SonOfPear93/gaggimate/hardware/knob/pcb/knob-main/fab/drc-report.txt

** Drc report for knob-main.kicad_pcb **
** Created on 2026-11-07T16:05:16 **
** Report includes: Errors, Warnings, Exclusions **

** Found 2 DRC violations **
[silk_edge_clearance]: Silkscreen clipped by board edge
    Rule: board setup constraints silk; warning
    @(100.0000 mm, 100.0000 mm): Circle on Edge.Cuts
    @(64.8000 mm, 95.3000 mm): Segment of J1 on F.Silkscreen
[silk_edge_clearance]: Silkscreen clipped by board edge
    Rule: board setup constraints silk; warning
    @(100.0000 mm, 100.0000 mm): Circle on Edge.Cuts
    @(64.8000 mm, 104.7000 mm): Segment of J1 on F.Silkscreen

** Found 0 unconnected pads **

** Found 0 Footprint errors **

** Ignored checks **
    - Footprint has no courtyard defined
    - Track endpoint not centered on via
    - Tuning profile track geometries
    - Footprint doesn't match symbol's footprint filters
    - Footprint component type doesn't match footprint pads

** End of Report **
