SonOfPear93/gaggimate/hardware/knob/pcb/knob-main/fab/erc-report.txt

ERC report (2026-11-07T16:05:14, Encoding UTF8)
Report includes: Errors, Warnings, Exclusions

***** Sheet /

 ** ERC messages: 0  Errors 0  Warnings 0

 ** Ignored checks:
    - Global label only appears once in the schematic
    - Four connection points are joined together
    - SPICE model issue
    - Assigned footprint doesn't match footprint filters
