SonOfPear93/gaggimate/hardware/knob/pcb/knob-screen/fab/drc-report.txt

** Drc report for knob-screen.kicad_pcb **
** Created on 2026-11-07T15:58:11 **
** Report includes: Errors, Warnings, Exclusions **

** Found 0 DRC violations **

** Found 0 unconnected pads **

** Found 0 Footprint errors **

** Ignored checks **
    - Footprint has no courtyard defined
    - Track endpoint not centered on via
    - Tuning profile track geometries
    - Footprint doesn't match symbol's footprint filters
    - Footprint component type doesn't match footprint pads

** End of Report **
