SonOfPear93/gaggimate/hardware/knob/pcb/knob-screen/fab/knob-screen-schematic.pdf

1 | 2 | 3 | 4 | 5 | 6 | 7 | 8
1 | 2 | 3 | 4 | 5 | 6 | 7 | 8

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
Size: A3 | Rev: 1 | F Date: 2026-11-07
KiCad E.D.A. 10.0.6 | Id: 1/1

### Title: GaggiMate Knob - board C (screen adapter)

File: knob-screen.kicad_sch

Sheet: /

GaggiMate Knob

Adapter between the 1.75in CO5300/CST9217 AMOLED (31-pin 0.3 mm FPC) and the 13-wire bundle to board B

FPC pinout copied from Waveshare ESP32-S3-Touch-AMOLED-1.75 schematic (J3). Panel makes its own AMOLED rails from 3V3.

I2C pull-ups for touch live on board B (to 3V3_LCD). No active parts on this board.

C1

10uF

TP1

LCD_TE

# Mounting 1

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
31 MP

J1

FH26W-31S-0.3SHW(60)

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
J2 WirePads13 H1M2 | H3M2 H2M2 | C4

100nF C3

100nF C2

1uF

GND

TP_SCL 3V3_LCD

3V3_LCD

3V3_LCD

GND

3V3_LCD
GND | 3V3_LCD GND 3V3_LCD
3V3_LCD | GND | 3V3_LCD | 3V3_LCD

TP_RST

TP_SCL

TP_INT | GND

LCD_D1

LCD_D0

# LCD_D3 GND

GND

# GND GND GND

LCD_D3 GND
LCD_TE
LCD_D2 | LCD_TE 3V3_LCD

LCD_CS
LCD_CLK

LCD_D2

LCD_CS GND

LCD_CLK

LCD_RST LCD_D0

LCD_D1

TP_SDA

TP_RST

TP_INT LCD_RST

TP_SDA Notes: - J1 sits on the panel-facing (top) side, positioned like Waveshare's J3 so the panel FPC tail folds behind

the glass and reaches it. FPC enters from -X (board left). Max part height on top: 1.0 mm (FPC fold gap ~2.3 mm). - J2 is 13 bare SMD pads on the bottom side in a ring r=5.5 mm around the board centre (motor hollow shaft). - Panel 3V3 (3V3_LCD) is switched on board B (LCD_EN). Bulk/HF decoupling here, close to the FPC 3V3 pins. - LCD_TE is brought to a test pad only.
