SonOfPear93/gaggimate/hardware/knob/pcb/knob-base/fab/knob-base-bottom.png

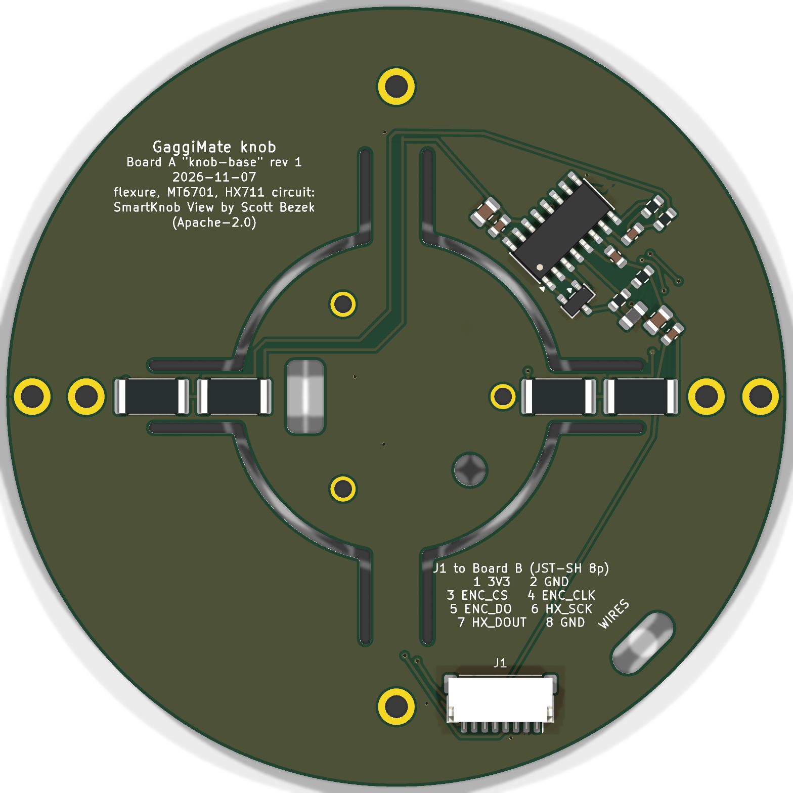
hardware/knob/pcb/knob-base/fab/knob-base-bottom.png
