SonOfPear93/gaggimate/hardware/knob/pcb/knob-main/fab/knob-main-render-bottom.png

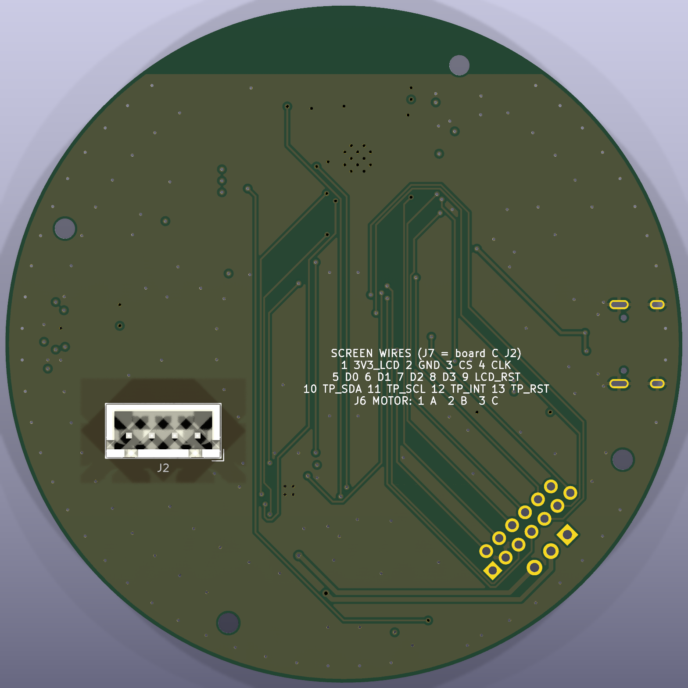
hardware/knob/pcb/knob-main/fab/knob-main-render-bottom.png
