SonOfPear93/gaggimate/hardware/knob/pcb/knob-main/fab/knob-main-render-top.png

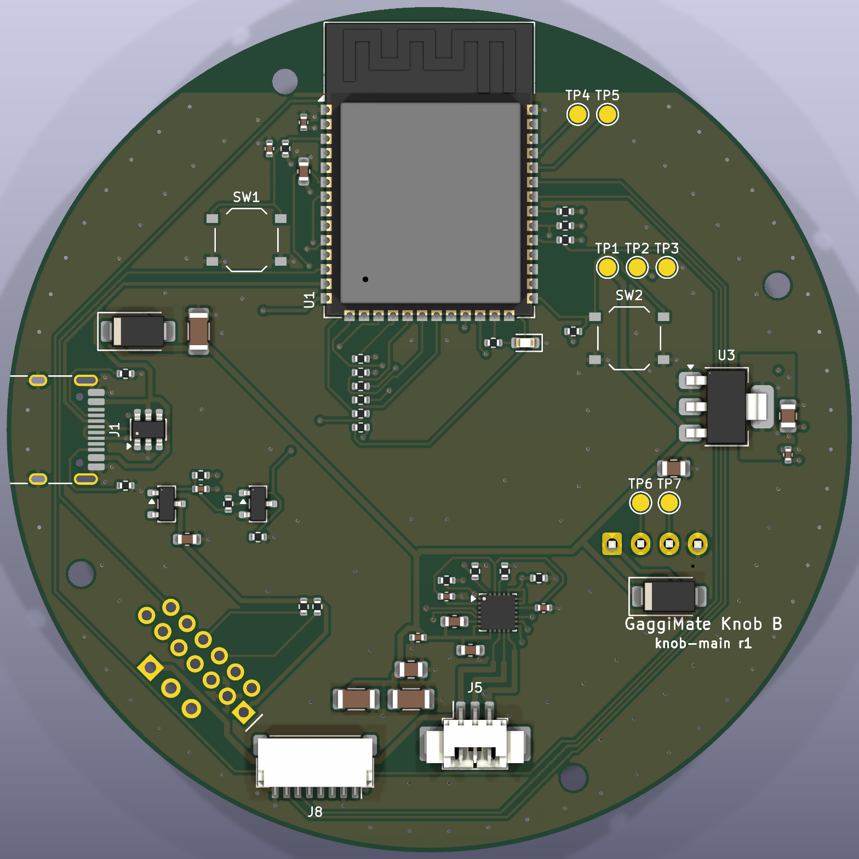
hardware/knob/pcb/knob-main/fab/knob-main-render-top.png
