SonOfPear93/gaggimate/hardware/knob/pcb/knob-screen/fab/knob-screen-render-bottom.png

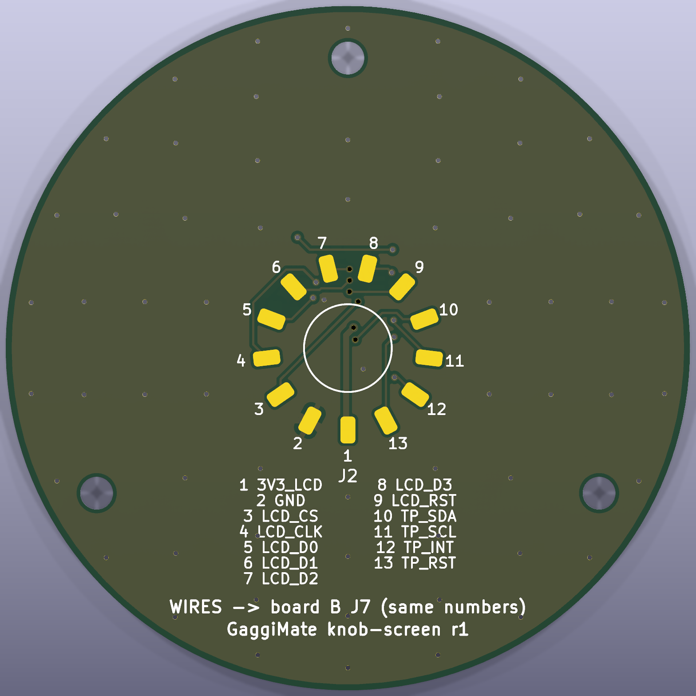
hardware/knob/pcb/knob-screen/fab/knob-screen-render-bottom.png
