SonOfPear93/gaggimate/hardware/knob/pcb/knob-screen/fab/knob-screen-render-top.png

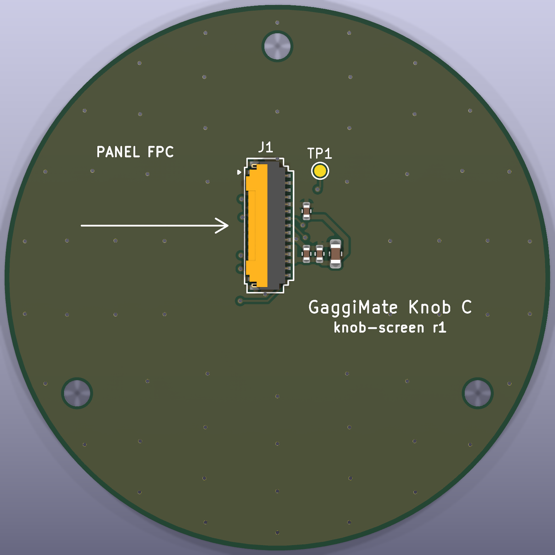
hardware/knob/pcb/knob-screen/fab/knob-screen-render-top.png
