SonOfPear93/gaggimate/hardware/knob/pcb/knob-main/fab/knob-main-BOM.csv

Comment | Designator | Footprint | LCSC
22uF/25V | C1,C14,C15 | C_1206_3216Metric | C12891
100nF/50V | C12,C13 | C_0603_1608Metric | C14663
10uF/25V | C2,C17 | C_0805_2012Metric | C15850
22uF | C3 | C_0805_2012Metric | C45783
100nF | C4,C6,C8,C10,C16 | C_0402_1005Metric | C1525
10uF | C5,C9 | C_0603_1608Metric | C19702
1uF | C7,C11 | C_0402_1005Metric | C52923
SS34 | D1,D2 | D_SMA | C8678
RED | D3 | LED_0603_1608Metric | C2286
USB-C | J1 | USB_C_Receptacle_HRO_TYPE-C-31-M-12 | C165948
B4B-XH-A | J2 | JST_XH_B4B-XH-A_1x04_P2.50mm_Vertical | C144395
53261-0371 | J5 | Molex_PicoBlade_53261-0371_1x03-1MP_P1.25mm_Horizontal | C293630
SM08B-SRSS-TB | J8 | JST_SH_SM08B-SRSS-TB_1x08-1MP_P1.00mm_Horizontal | C160407
AO3401A | Q1 | SOT-23 | C15127
2N7002 | Q2 | SOT-23 | C8545
5.1k | R1,R2 | R_0402_1005Metric | C25905
4.7k | R12,R13 | R_0402_1005Metric | C25900
100k | R14,R16,R18,R19 | R_0402_1005Metric | C25741
47k | R20 | R_0402_1005Metric | C25792
2.2k | R21,R22,R23 | R_0402_1005Metric | C25879
10k | R3,R4,R15,R17 | R_0402_1005Metric | C25744
1k | R5 | R_0402_1005Metric | C11702
33R | R6,R7,R8,R9,R10,R11 | R_0402_1005Metric | C25105
RESET | SW1 | SW_Push_1P1T_XKB_TS-1187A | C318884
BOOT | SW2 | SW_Push_1P1T_XKB_TS-1187A | C318884
ESP32-S3-WROOM-1-N16R8 | U1 | ESP32-S3-WROOM-1_EPvia0.3 | C2913202
USBLC6-2SC6 | U2 | SOT-23-6 | C2687116
AP7361C-33ER-13 | U3 | SOT-223-3_TabPin2 | C3743528
DRV8311HRRWR | U4 | Texas_RRW0024A_WQFN-24-1EP_3x3mm_P0.4mm_EP1.9x1.9mm | C5218862
