SonOfPear93/gaggimate/hardware/knob/pcb/knob-screen/fab/knob-screen-BOM.csv

Comment | Designator | Footprint | LCSC
10uF | C1 | C_0603_1608Metric | C19702
1uF | C2 | C_0402_1005Metric | C52923
100nF | C3,C4 | C_0402_1005Metric | C1525
FH26W-31S-0.3SHW(60) | J1 | Hirose_FH26-31S-0.3SHW_2Rows-31Pins-1MP_P0.60mm_Horizontal | C2973806
