SonOfPear93/gaggimate/hardware/knob/pcb/knob-base/fab/knob-base-BOM-JLC.csv

Comment | Designator | Footprint | LCSC Part #
100n | C12,C19,C20,C22,C23 | C_0603_1608Metric | C14663
10u | C16,C18 | C_0805_2012Metric | C15850
100R@100MHz | FB1 | L_0805_2012Metric | C1015
JST-SH 8p to Board B | J1 | JST_SH_SM08B-SRSS-TB_1x08-1MP_P1.00mm_Horizontal | C160407
SS8550 | Q1 | SOT-23 | C8542
10k | R3 | R_0603_1608Metric | C25804
8.2k | R4 | R_0603_1608Metric | C25981
100 | R5,R6 | R_0603_1608Metric | C22775
330 (strain) | R18,R19,R20,R21 | R_2512_6332Metric | C19866
MT6701CT-STD-R | U1 | SOIC-8_3.9x4.9mm_P1.27mm | C3003196
HX711 | U4 | SOIC-16_3.9x9.9mm_P1.27mm | C6705483
