SonOfPear93/gaggimate/hardware/knob/mechanical/reused/RotorSpacer.stl

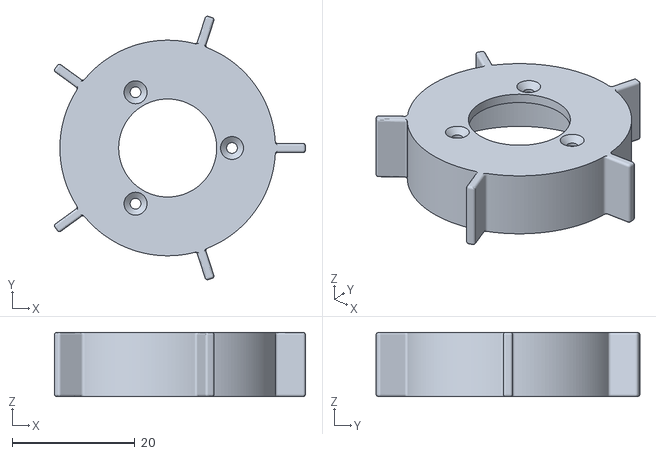
[picture p6: CAD file, 2026-11-07]
hardware/knob/mechanical/reused/RotorSpacer.stl
41.0 x 43.0 x 10.5
