SonOfPear93/gaggimate/hardware/knob/pcb/knob-main/knob-main.kicad_pcb

## KiCad design hardware/knob/pcb/knob-main/knob-main.kicad_pcb (2026-11-07)

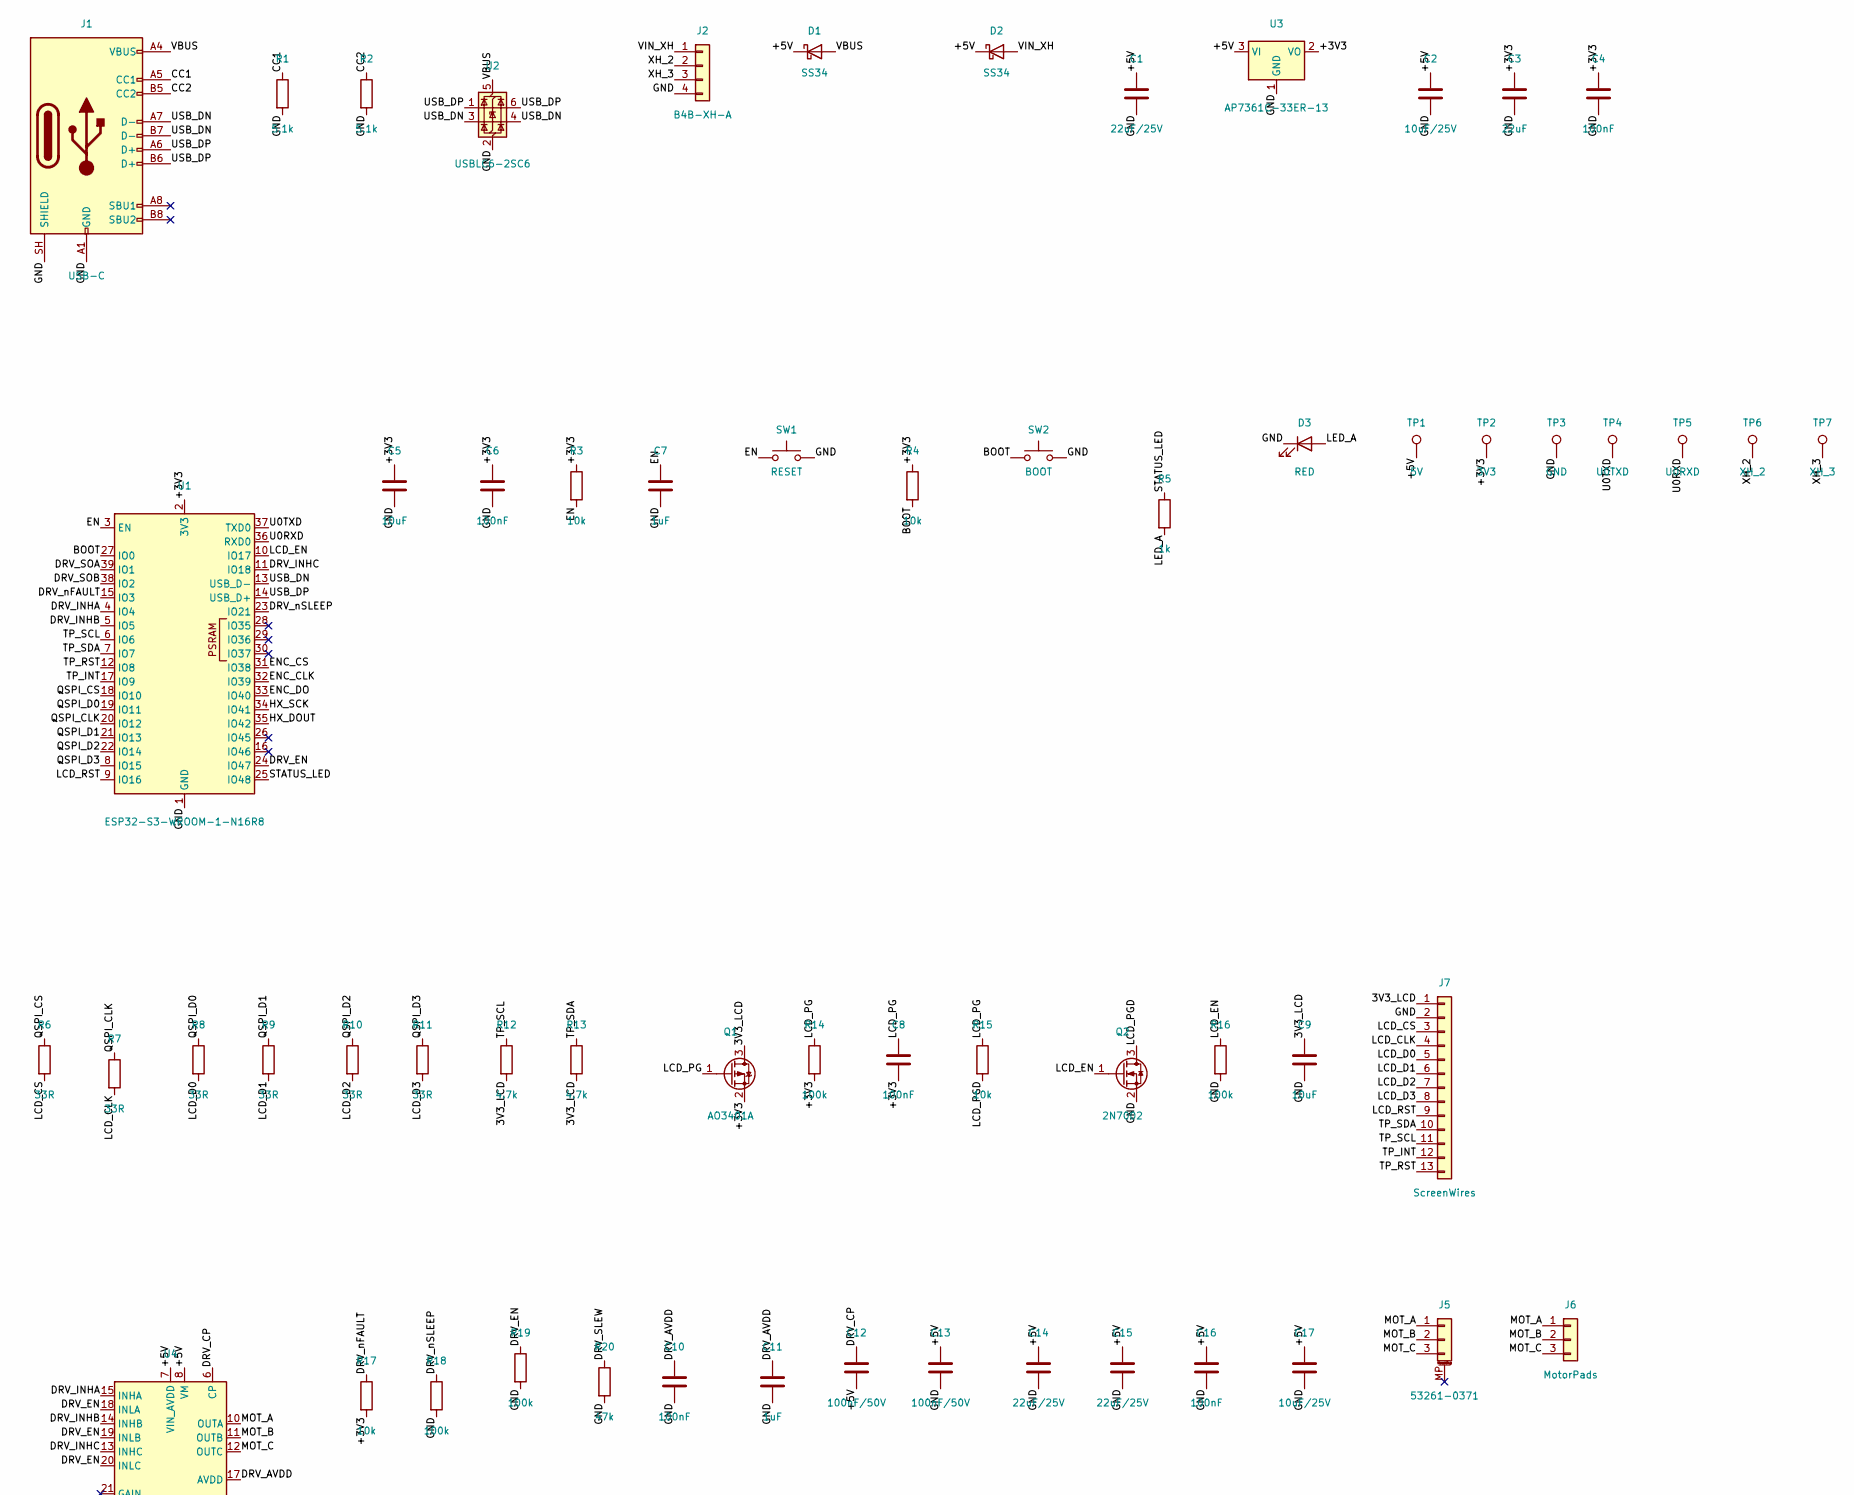
[picture p9: schematic knob-main.kicad_sch, GaggiMate Knob - board B (main: ESP32-S3, DRV8311H, power), part in row 1, column 1]

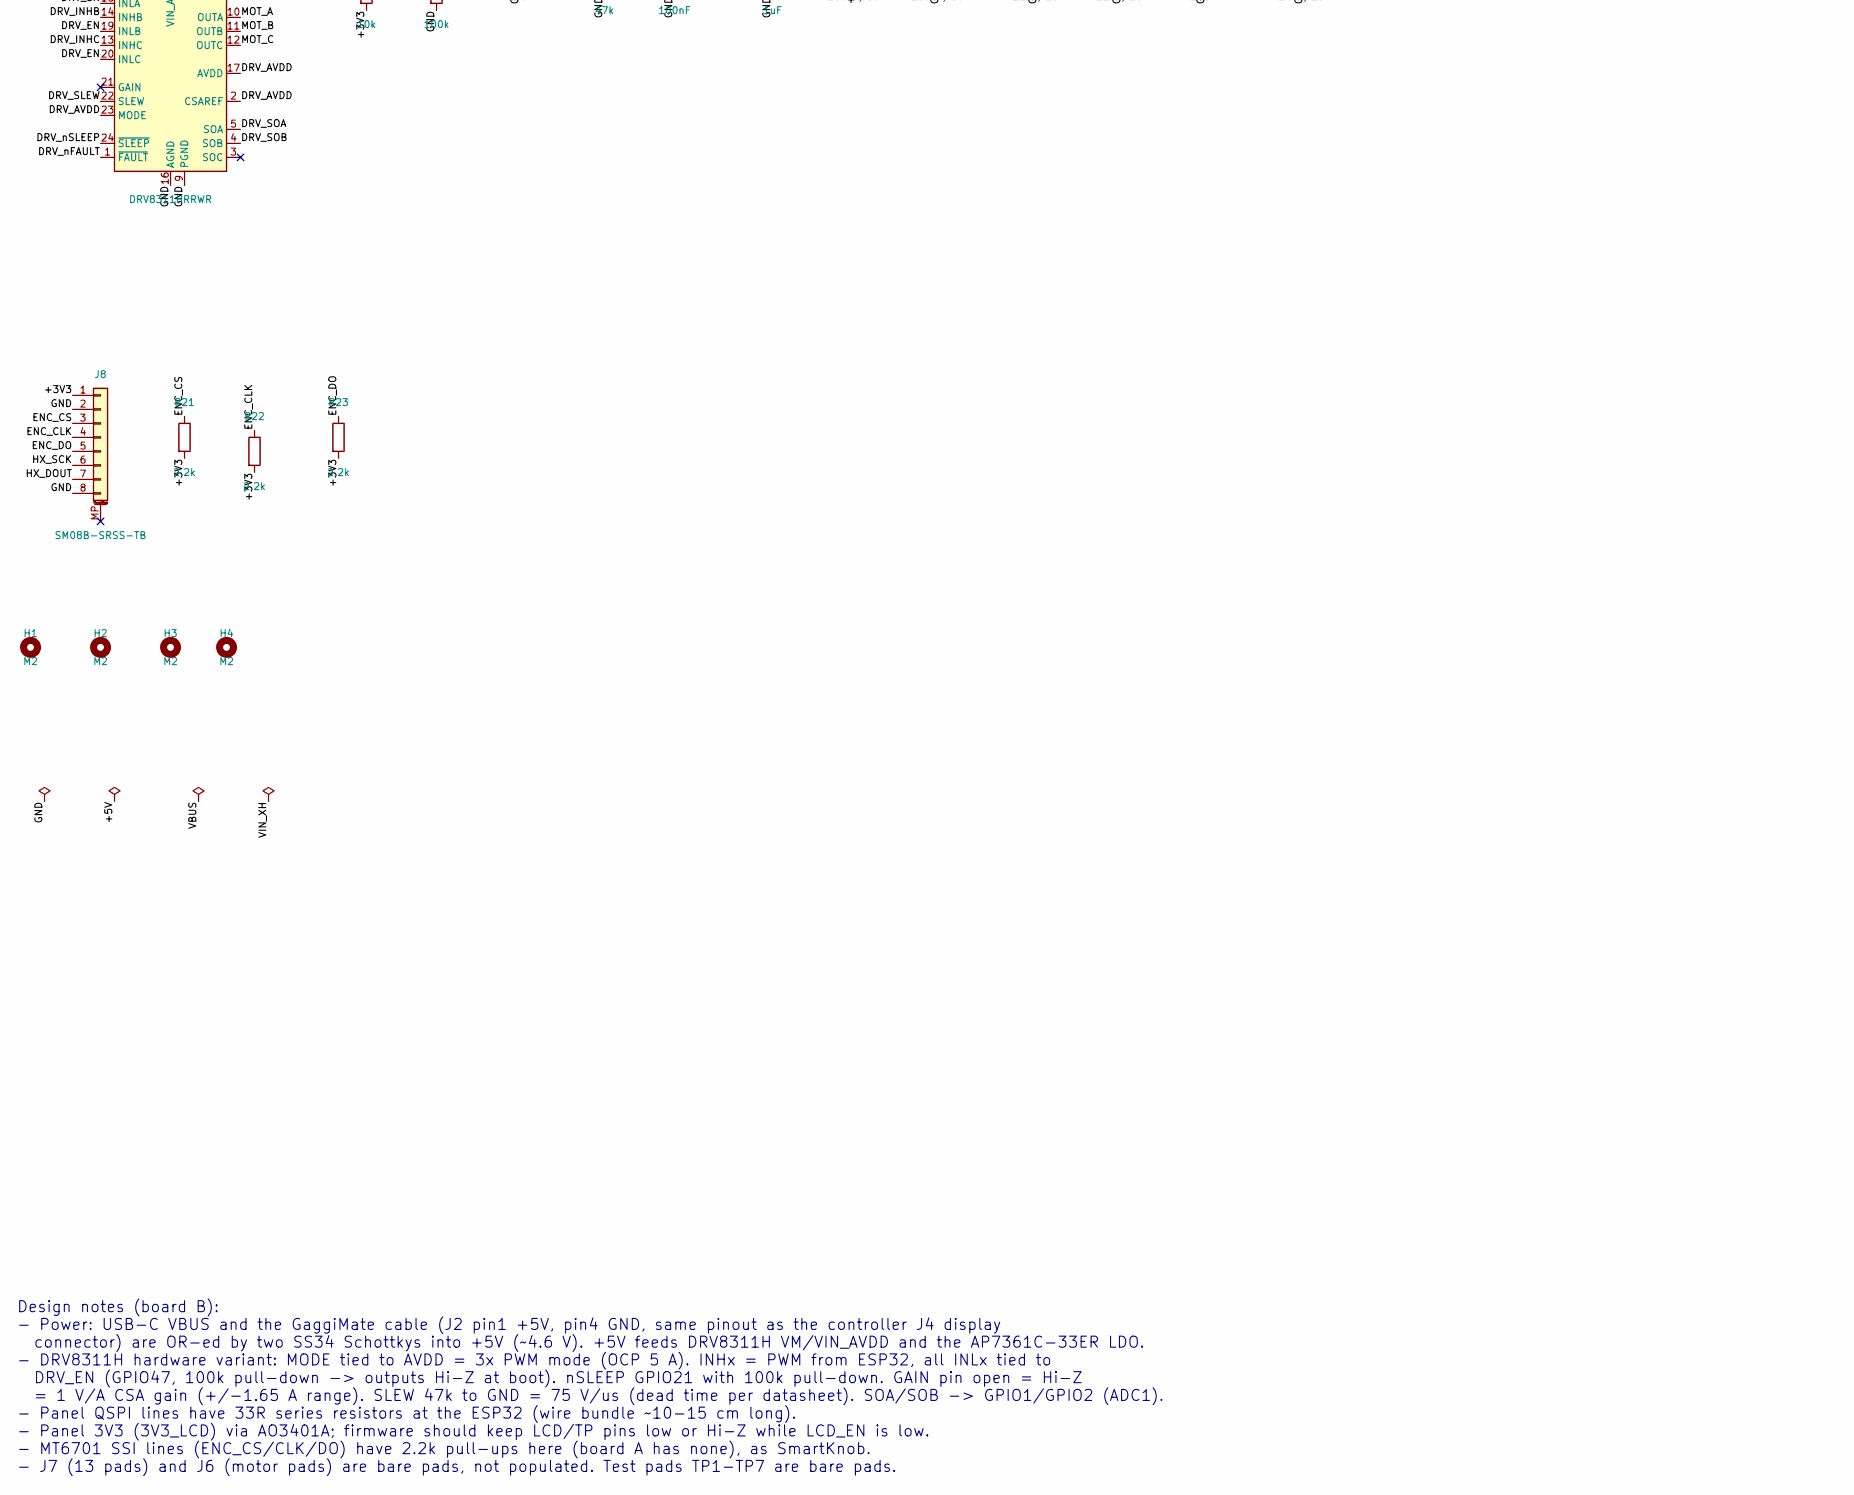
[picture p10: schematic knob-main.kicad_sch, GaggiMate Knob - board B (main: ESP32-S3, DRV8311H, power), part in row 2, column 1]

Parts:
C1, C14, C15: 22uF/25V; C_1206_3216Metric; MPN CL31A226KAHNNNE; LCSC C12891
C2, C17: 10uF/25V; C_0805_2012Metric; MPN CL21A106KAYNNNE; LCSC C15850
C3: 22uF; C_0805_2012Metric; MPN CL21A226MAQNNNE; LCSC C45783
C4, C6, C8, C10, C16: 100nF; C_0402_1005Metric; MPN CL05B104KO5NNNC; LCSC C1525
C5, C9: 10uF; C_0603_1608Metric; MPN CL10A106KP8NNNC; LCSC C19702
C7, C11: 1uF; C_0402_1005Metric; MPN CL05A105KA5NQNC; LCSC C52923
C12, C13: 100nF/50V; C_0603_1608Metric; MPN CC0603KRX7R9BB104; LCSC C14663
D1, D2: SS34; D_SMA; MPN SS34; LCSC C8678
D3: RED; LED_0603_1608Metric; MPN KT-0603R; LCSC C2286
H1, H2, H3, H4: M2; MountingHole_2.2mm_M2
J1: USB-C; USB_C_Receptacle_HRO_TYPE-C-31-M-12; MPN TYPE-C-31-M-12; LCSC C165948
J2: B4B-XH-A; JST_XH_B4B-XH-A_1x04_P2.50mm_Vertical; MPN B4B-XH-A(LF)(SN); LCSC C144395
J5: 53261-0371; Molex_PicoBlade_53261-0371_1x03-1MP_P1.25mm_Horizontal; MPN 532610371; LCSC C293630
J6: MotorPads; MotorPads_3_P2.54mm
J7: ScreenWires; WirePads_13_2Rows_P2.0mm
J8: SM08B-SRSS-TB; JST_SH_SM08B-SRSS-TB_1x08-1MP_P1.00mm_Horizontal; MPN SM08B-SRSS-TB(LF)(SN); LCSC C160407
Q1: AO3401A; SOT-23; MPN AO3401A; LCSC C15127
Q2: 2N7002; SOT-23; MPN 2N7002; LCSC C8545
R1, R2: 5.1k; R_0402_1005Metric; MPN 0402WGF5101TCE; LCSC C25905
R3, R4, R15, R17: 10k; R_0402_1005Metric; MPN 0402WGF1002TCE; LCSC C25744
R5: 1k; R_0402_1005Metric; MPN 0402WGF1001TCE; LCSC C11702
R6, R7, R8, R9, R10, R11: 33R; R_0402_1005Metric; MPN 0402WGF330JTCE; LCSC C25105
R12, R13: 4.7k; R_0402_1005Metric; MPN 0402WGF4701TCE; LCSC C25900
R14, R16, R18, R19: 100k; R_0402_1005Metric; MPN 0402WGF1003TCE; LCSC C25741
R20: 47k; R_0402_1005Metric; MPN 0402WGF4702TCE; LCSC C25792
R21, R22, R23: 2.2k; R_0402_1005Metric; MPN 0402WGF2201TCE; LCSC C25879
SW1: RESET; SW_Push_1P1T_XKB_TS-1187A; MPN TS-1187A-B-A-B; LCSC C318884
SW2: BOOT; SW_Push_1P1T_XKB_TS-1187A; MPN TS-1187A-B-A-B; LCSC C318884
TP1: 5V; TestPoint_Pad_D1.5mm
TP2: 3V3; TestPoint_Pad_D1.5mm
TP3: GND; TestPoint_Pad_D1.5mm
TP4: U0TXD; TestPoint_Pad_D1.5mm
TP5: U0RXD; TestPoint_Pad_D1.5mm
TP6: XH_2; TestPoint_Pad_D1.5mm
TP7: XH_3; TestPoint_Pad_D1.5mm
U1: ESP32-S3-WROOM-1-N16R8; ESP32-S3-WROOM-1_EPvia0.3; MPN ESP32-S3-WROOM-1-N16R8; LCSC C2913202
U2: USBLC6-2SC6; SOT-23-6; MPN USBLC6-2SC6; LCSC C2687116
U3: AP7361C-33ER-13; SOT-223-3_TabPin2; MPN AP7361C-33ER-13; LCSC C3743528
U4: DRV8311HRRWR; Texas_RRW0024A_WQFN-24-1EP_3x3mm_P0.4mm_EP1.9x1.9mm; MPN DRV8311HRRWR; LCSC C5218862

Connections:
/3V3_LCD: C9.1, J7.1, Q1.3 (D), R12.2, R13.2
/+3V3: C3.1, C4.1, C5.1, C6.1, C8.2, J8.1, Q1.2 (S), R3.1, R4.1, R14.2, R17.2, R21.2, R22.2, R23.2, TP2.1, U1.2 (3V3), U3.2 (VO)
/+5V: C1.1, C2.1, C12.2, C13.1, C14.1, C15.1, C16.1, C17.1, D1.1 (K), D2.1 (K), TP1.1, U3.3 (VI), U4.7 (VIN_AVDD), U4.8 (VM)
/BOOT: R4.2, SW2.1, U1.27 (IO0)
/CC1: J1.A5 (CC1), R1.1
/CC2: J1.B5 (CC2), R2.1
/DRV_AVDD: C10.1, C11.1, U4.2 (CSAREF), U4.17 (AVDD), U4.23 (MODE)
/DRV_CP: C12.1, U4.6 (CP)
/DRV_EN: R19.1, U1.24 (IO47), U4.18 (INLA), U4.19 (INLB), U4.20 (INLC)
/DRV_INHA: U1.4 (IO4), U4.15 (INHA)
/DRV_INHB: U1.5 (IO5), U4.14 (INHB)
/DRV_INHC: U1.11 (IO18), U4.13 (INHC)
/DRV_SLEW: R20.1, U4.22 (SLEW)
/DRV_SOA: U1.39 (IO1), U4.5 (SOA)
/DRV_SOB: U1.38 (IO2), U4.4 (SOB)
/DRV_nFAULT: R17.1, U1.15 (IO3), U4.1 (~FAULT)
/DRV_nSLEEP: R18.1, U1.23 (IO21), U4.24 (~SLEEP)
/EN: C7.1, R3.2, SW1.1, U1.3 (EN)
/ENC_CLK: J8.4, R22.1, U1.32 (IO39)
/ENC_CS: J8.3, R21.1, U1.31 (IO38)
/ENC_DO: J8.5, R23.1, U1.33 (IO40)
/GND: C1.2, C2.2, C3.2, C4.2, C5.2, C6.2, C7.2, C9.2, C10.2, C11.2, C13.2, C14.2, C15.2, C16.2, C17.2, D3.1 (K), J1.A1 (GND), J1.A12 (GND), J1.B1 (GND), J1.B12 (GND), J1.SH (SHIELD), J2.4, J7.2, J8.2, J8.8, Q2.2 (S), R1.2, R2.2, R16.2, R18.2, R19.2, R20.2, SW1.2, SW2.2, TP3.1, U1.1 (GND), U1.40 (GND), U1.41 (GND), U2.2 (GND), U3.1 (GND), U4.9 (PGND), U4.16 (AGND), U4.25 (PGND)
/HX_DOUT: J8.7, U1.35 (IO42)
/HX_SCK: J8.6, U1.34 (IO41)
/LCD_CLK: J7.4, R7.2
/LCD_CS: J7.3, R6.2
/LCD_D0: J7.5, R8.2
/LCD_D1: J7.6, R9.2
/LCD_D2: J7.7, R10.2
/LCD_D3: J7.8, R11.2
/LCD_EN: Q2.1 (G), R16.1, U1.10 (IO17)
/LCD_PG: C8.1, Q1.1 (G), R14.1, R15.1
/LCD_PGD: Q2.3 (D), R15.2
/LCD_RST: J7.9, U1.9 (IO16)
/LED_A: D3.2 (A), R5.2
/MOT_A: J5.1, J6.1, U4.10 (OUTA)
/MOT_B: J5.2, J6.2, U4.11 (OUTB)
/MOT_C: J5.3, J6.3, U4.12 (OUTC)
/QSPI_CLK: R7.1, U1.20 (IO12)
/QSPI_CS: R6.1, U1.18 (IO10)
/QSPI_D0: R8.1, U1.19 (IO11)
/QSPI_D1: R9.1, U1.21 (IO13)
/QSPI_D2: R10.1, U1.22 (IO14)
/QSPI_D3: R11.1, U1.8 (IO15)
/STATUS_LED: R5.1, U1.25 (IO48)
/TP_INT: J7.12, U1.17 (IO9)
/TP_RST: J7.13, U1.12 (IO8)
/TP_SCL: J7.11, R12.1, U1.6 (IO6)
/TP_SDA: J7.10, R13.1, U1.7 (IO7)
/U0RXD: TP5.1, U1.36 (RXD0)
/U0TXD: TP4.1, U1.37 (TXD0)
/USB_DN: J1.A7 (D-), J1.B7 (D-), U1.13 (USB_D-), U2.3 (I/O2), U2.4 (I/O2)
/USB_DP: J1.A6 (D+), J1.B6 (D+), U1.14 (USB_D+), U2.1 (I/O1), U2.6 (I/O1)
/VBUS: D1.2 (A), J1.A4 (VBUS), J1.A9 (VBUS), J1.B4 (VBUS), J1.B9 (VBUS), U2.5 (VBUS)
/VIN_XH: D2.2 (A), J2.1
/XH_2: J2.2, TP6.1
/XH_3: J2.3, TP7.1

Notes on the sheet:
Design notes (board B): - Power: USB-C VBUS and the GaggiMate cable (J2 pin1 +5V, pin4 GND, same pinout as the controller J4 display connector) are OR-ed by two SS34 Schottkys into +5V (~4.6 V). +5V feeds DRV8311H VM/VIN_AVDD and the AP7361C-33ER LDO. - DRV8311H hardware variant: MODE tied to AVDD 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

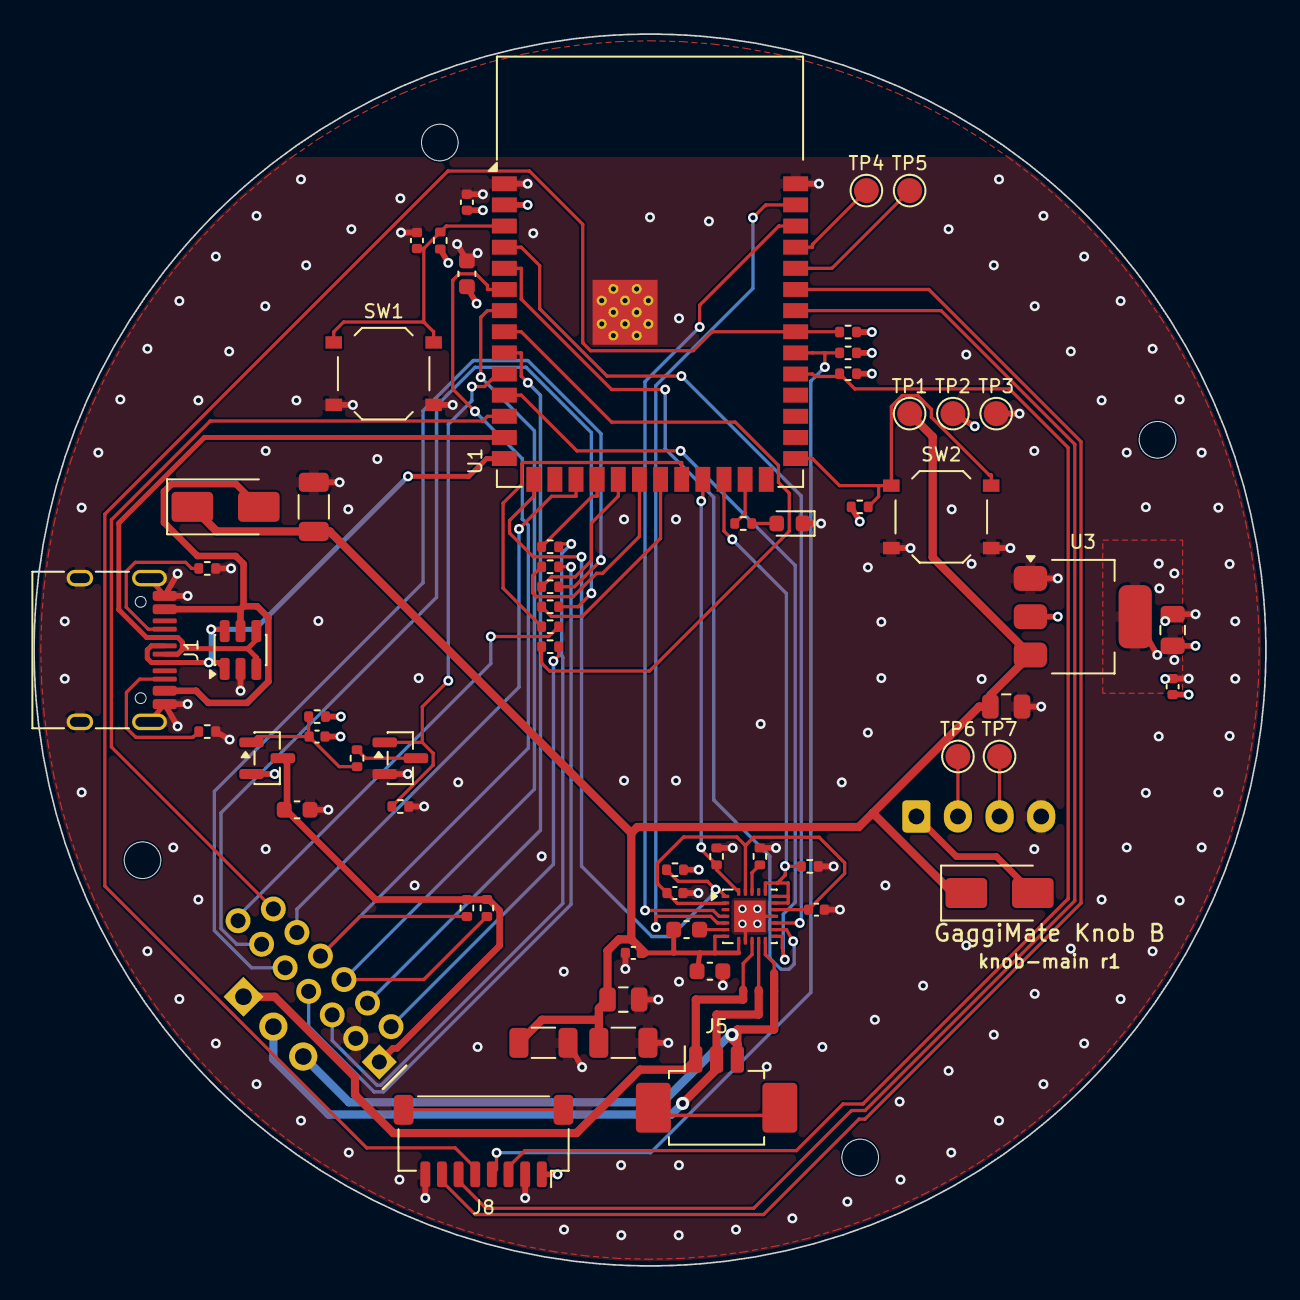
[picture p11: board knob-main.kicad_pcb from above]

Board: 4 copper layers, 74.0 x 74.0 mm, 68 parts (1 on the bottom side), 57 nets.
