SonOfPear93/gaggimate/hardware/knob/pcb/knob-screen/knob-screen.kicad_pcb

## KiCad design hardware/knob/pcb/knob-screen/knob-screen.kicad_pcb (2026-11-07)

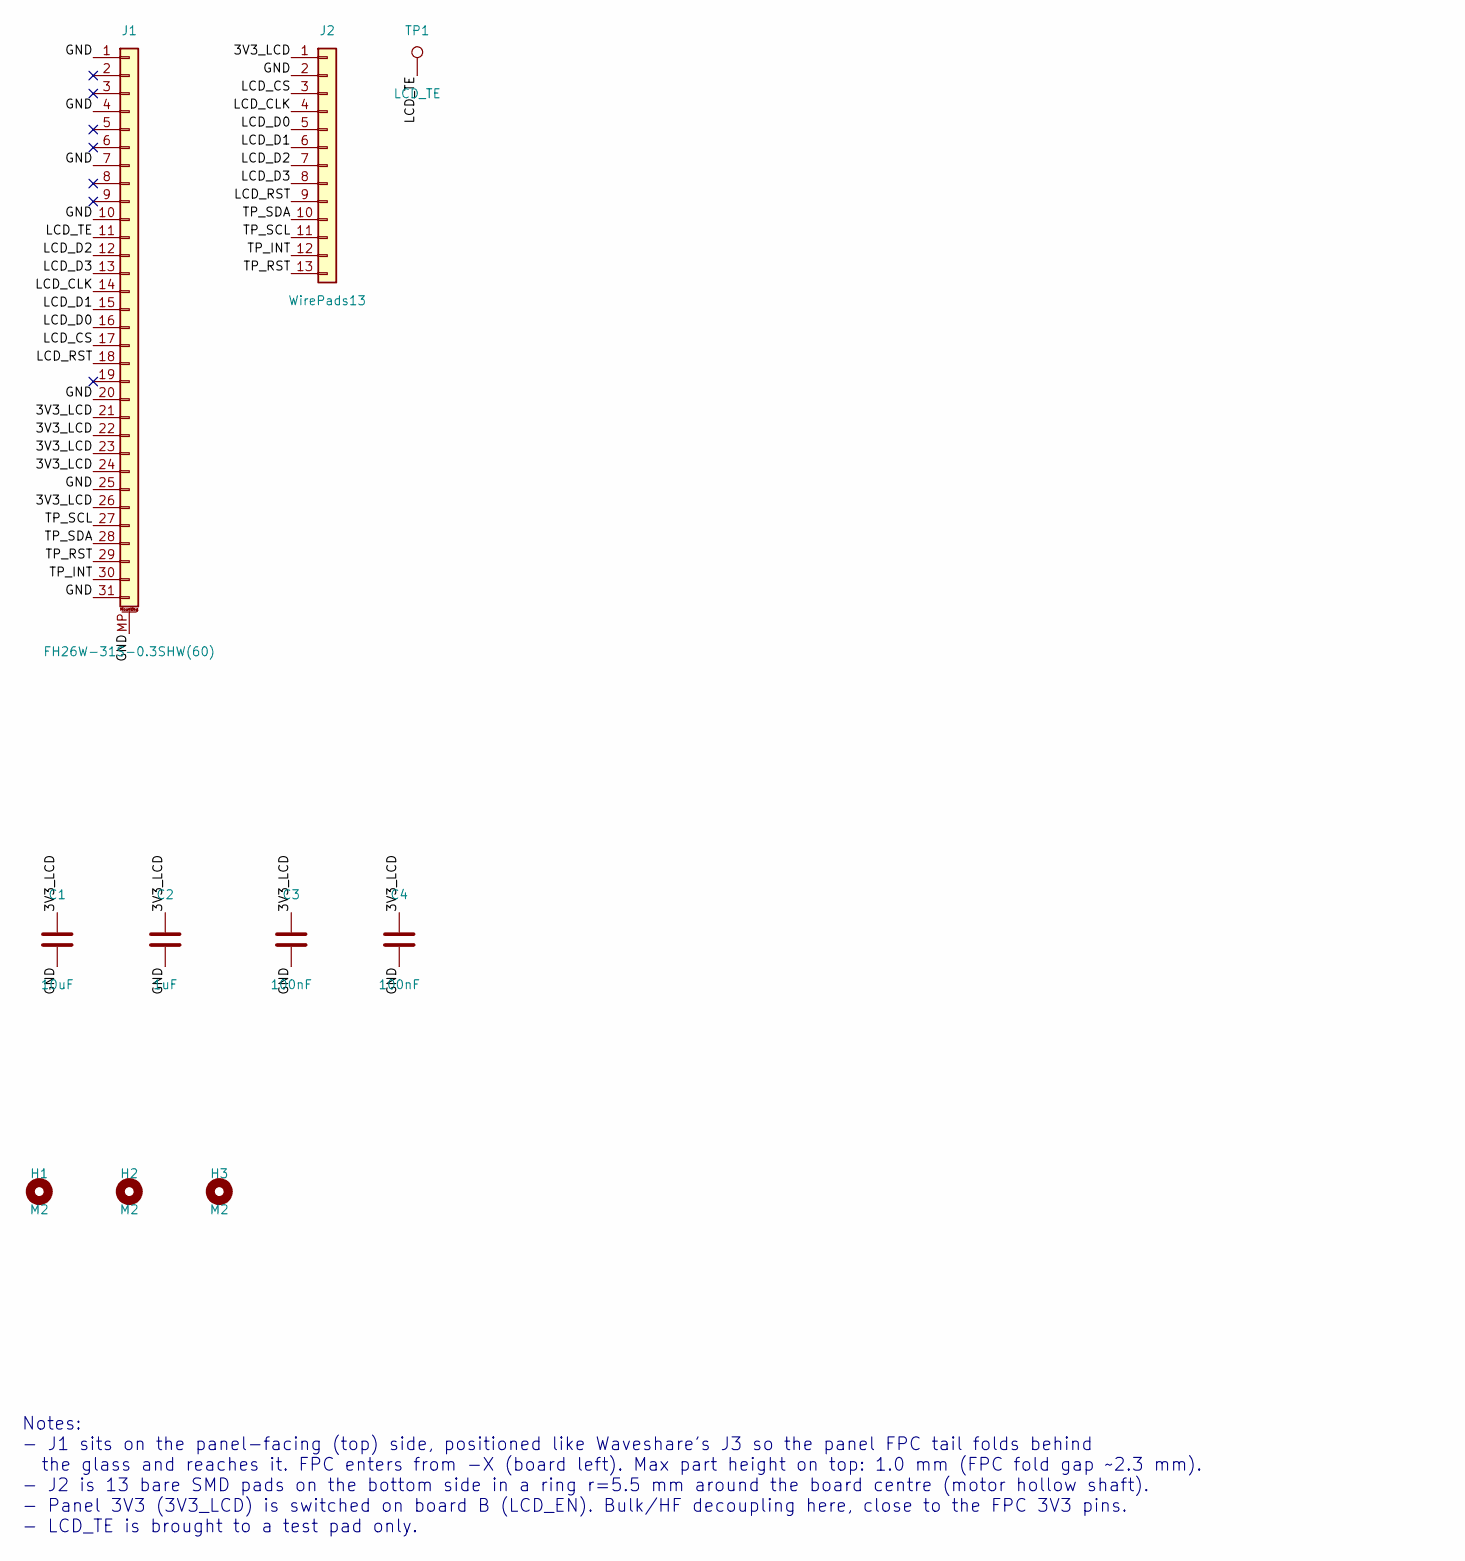
[picture p12: schematic knob-screen.kicad_sch, GaggiMate Knob - board C (screen adapter)]

Parts:
C1: 10uF; C_0603_1608Metric; MPN CL10A106KP8NNNC; LCSC C19702
C2: 1uF; C_0402_1005Metric; MPN CL05A105KA5NQNC; LCSC C52923
C3, C4: 100nF; C_0402_1005Metric; MPN CL05B104KO5NNNC; LCSC C1525
H1, H2, H3: M2; MountingHole_2.2mm_M2
J1: FH26W-31S-0.3SHW(60); Hirose_FH26-31S-0.3SHW_2Rows-31Pins-1MP_P0.60mm_Horizontal; MPN FH26W-31S-0.3SHW(60); LCSC C2973806
J2: WirePads13; WirePads_Ring13_R5.5mm
TP1: LCD_TE; TestPoint_Pad_D1.0mm

Connections:
/3V3_LCD: C1.1, C2.1, C3.1, C4.1, J1.21, J1.22, J1.23, J1.24, J1.26, J2.1
/GND: C1.2, C2.2, C3.2, C4.2, J1.1, J1.4, J1.7, J1.10, J1.20, J1.25, J1.31, J1.MP (MountPin), J2.2
/LCD_CLK: J1.14, J2.4
/LCD_CS: J1.17, J2.3
/LCD_D0: J1.16, J2.5
/LCD_D1: J1.15, J2.6
/LCD_D2: J1.12, J2.7
/LCD_D3: J1.13, J2.8
/LCD_RST: J1.18, J2.9
/LCD_TE: J1.11, TP1.1
/TP_INT: J1.30, J2.12
/TP_RST: J1.29, J2.13
/TP_SCL: J1.27, J2.11
/TP_SDA: J1.28, J2.10

Notes on the sheet:
Notes: - J1 sits on the panel-facing (top) side, positioned like Waveshare's J3 so the panel FPC tail folds behind the glass and reaches it. FPC enters from -X (board left). Max part height on top: 1.0 mm (FPC fold gap ~2.3 mm). - J2 is 13 bare SMD pads on the bottom side in a ring r=5.5 mm around 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

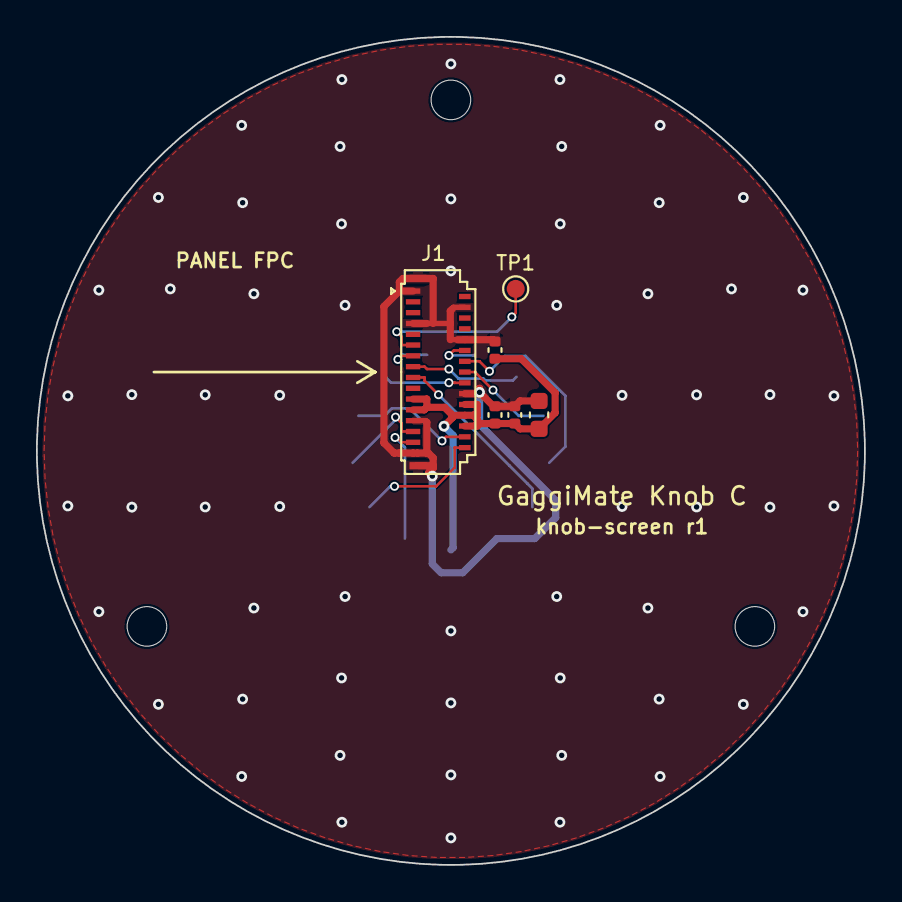
[picture p13: board knob-screen.kicad_pcb from above]

Board: 2 copper layers, 46.0 x 46.0 mm, 10 parts (1 on the bottom side), 14 nets.
