SonOfPear93/gaggimate/hardware/knob/pcb/knob-base/knob-base.kicad_pcb

## KiCad design hardware/knob/pcb/knob-base/knob-base.kicad_pcb (2026-11-07)

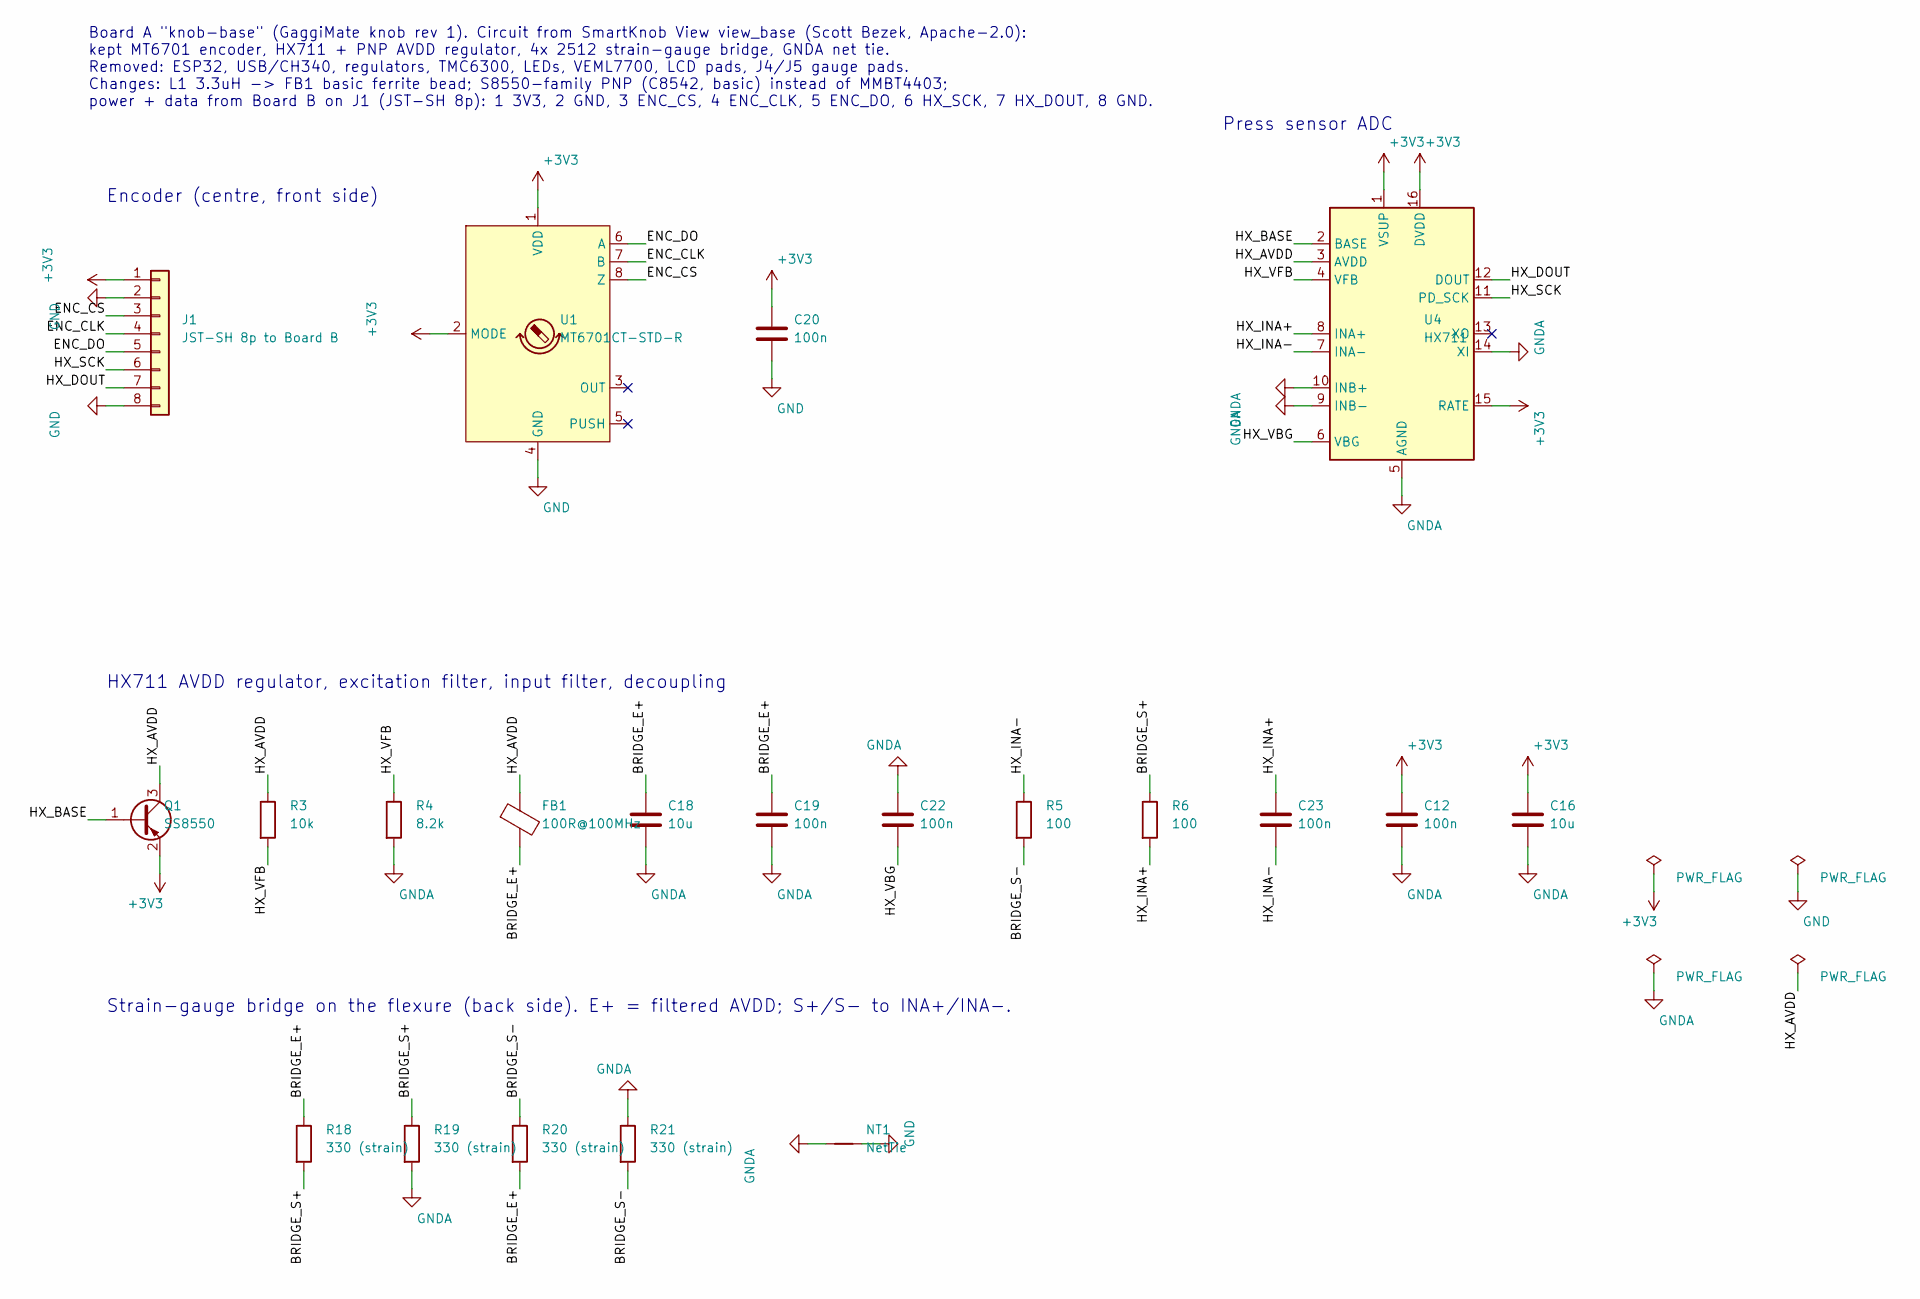
[picture p14: schematic knob-base.kicad_sch, GaggiMate knob - Board A knob-base]

Parts:
C12, C19, C20, C22, C23: 100n; C_0603_1608Metric; MPN CC0603KRX7R9BB104; LCSC C14663
C16, C18: 10u; C_0805_2012Metric; MPN CL21A106KAYNNNE; LCSC C15850
FB1: 100R@100MHz; L_0805_2012Metric; MPN GZ2012D101TF; LCSC C1015
J1: JST-SH 8p to Board B; JST_SH_SM08B-SRSS-TB_1x08-1MP_P1.00mm_Horizontal; MPN SM08B-SRSS-TB(LF)(SN); LCSC C160407
NT1: NetTie; NetTie-2_SMD_Pad0.5mm
Q1: SS8550; SOT-23; MPN SS8550 Y2; LCSC C8542
R3: 10k; R_0603_1608Metric; MPN 0603WAF1002T5E; LCSC C25804
R4: 8.2k; R_0603_1608Metric; MPN 0603WAF8201T5E; LCSC C25981
R5, R6: 100; R_0603_1608Metric; MPN 0603WAF1000T5E; LCSC C22775
R18, R19, R20, R21: 330 (strain); R_2512_6332Metric; MPN 25121WJ0331T4E; LCSC C19866
U1: MT6701CT-STD-R; SOIC-8_3.9x4.9mm_P1.27mm; MPN MT6701CT-STD-R; LCSC C3003196
U4: HX711; SOIC-16_3.9x9.9mm_P1.27mm; MPN HX711; LCSC C6705483

Connections:
+3V3: C12.1, C16.1, C20.1, J1.1, Q1.2 (E), U1.1 (VDD), U1.2 (MODE), U4.1 (VSUP), U4.15 (RATE), U4.16 (DVDD)
/BRIDGE_E+: C18.1, C19.1, FB1.2, R18.1, R20.2
/BRIDGE_S+: R6.1, R18.2, R19.1
/BRIDGE_S-: R5.2, R20.1, R21.2
/ENC_CLK: J1.4, U1.7 (B)
/ENC_CS: J1.3, U1.8 (Z)
/ENC_DO: J1.5, U1.6 (A)
/HX_AVDD: FB1.1, Q1.3 (C), R3.1, U4.3 (AVDD)
/HX_BASE: Q1.1 (B), U4.2 (BASE)
/HX_DOUT: J1.7, U4.12 (DOUT)
/HX_INA+: C23.1, R6.2, U4.8 (INA+)
/HX_INA-: C23.2, R5.1, U4.7 (INA-)
/HX_SCK: J1.6, U4.11 (PD_SCK)
/HX_VBG: C22.2, U4.6 (VBG)
/HX_VFB: R3.2, R4.1, U4.4 (VFB)
GND: C20.2, J1.2, J1.8, NT1.2, U1.4 (GND)
GNDA: C12.2, C16.2, C18.2, C19.2, C22.1, NT1.1, R4.2, R19.2, R21.1, U4.5 (AGND), U4.9 (INB-), U4.10 (INB+), U4.14 (XI)

Notes on the sheet:
Board A "knob-base" (GaggiMate knob rev 1). Circuit from SmartKnob View view_base (Scott Bezek, Apache-2.0): kept MT6701 encoder, HX711 + PNP AVDD regulator, 4x 2512 strain-gauge bridge, GNDA net tie. Removed: ESP32, USB/CH340, regulators, TMC6300, LEDs, VEML7700, LCD pads, J4/J5 gauge pads. Change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
Encoder (centre, front side)
Press sensor ADC
HX711 AVDD regulator, excitation filter, input filter, decoupling
Strain-gauge bridge on the flexure (back side). E+ = filtered AVDD; S+/S- to INA+/INA-.

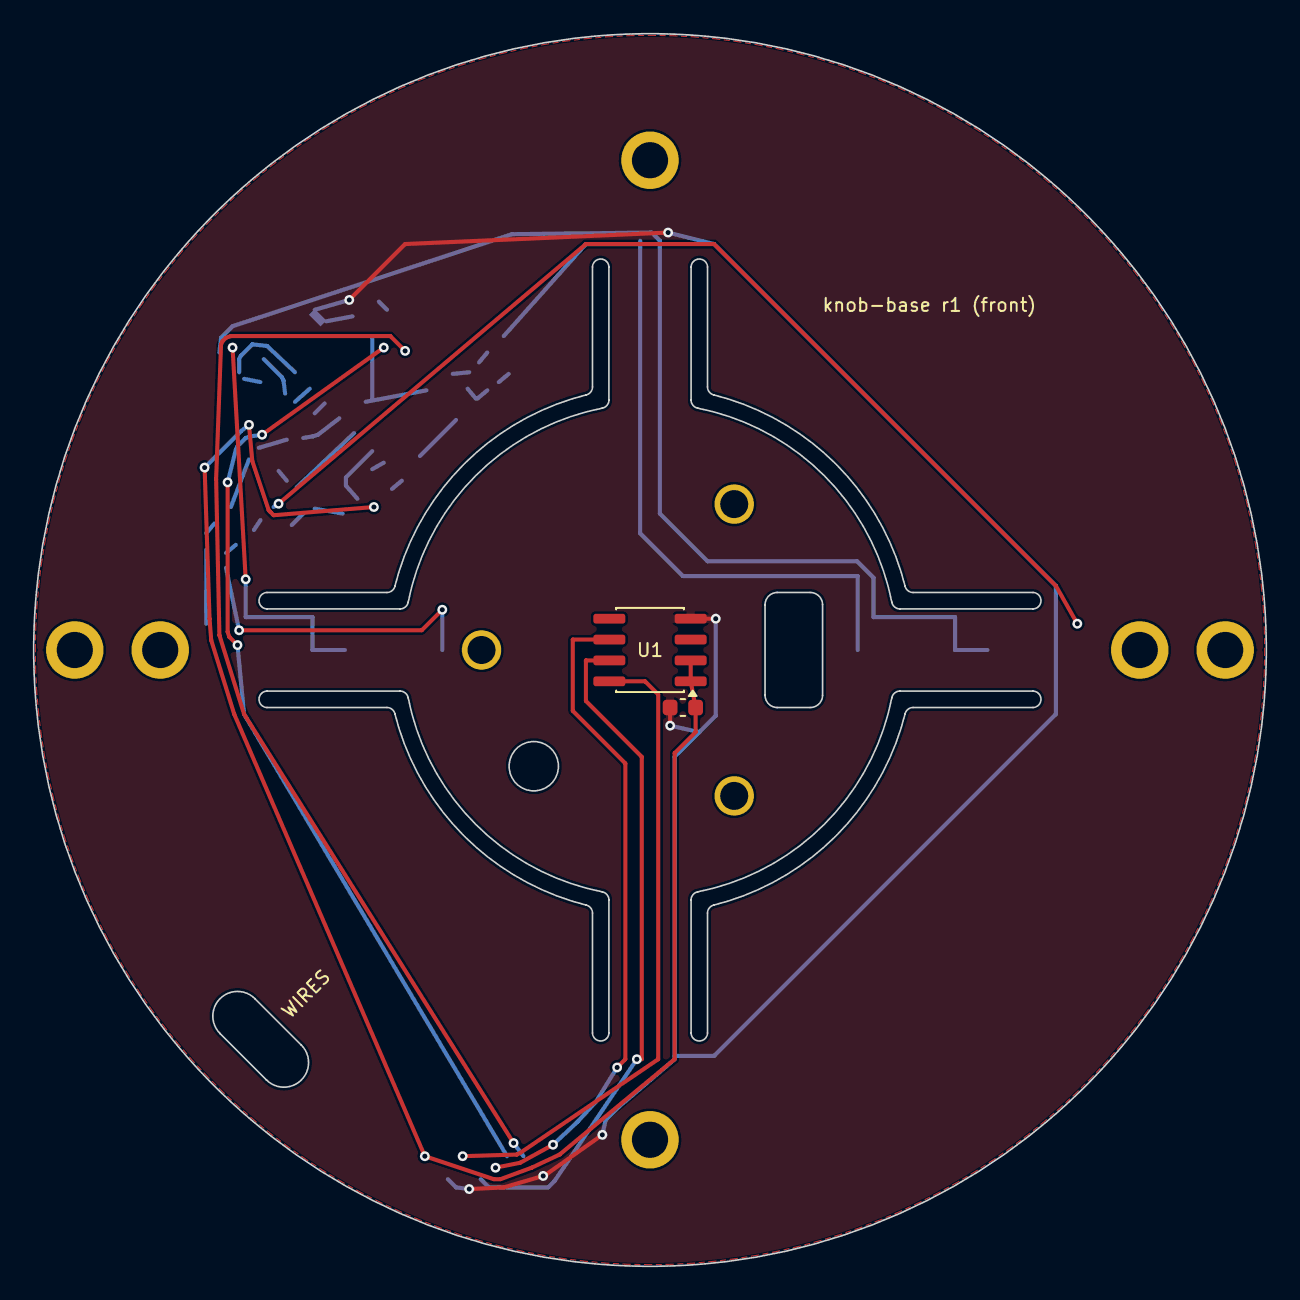
[picture p15: board knob-base.kicad_pcb from above]

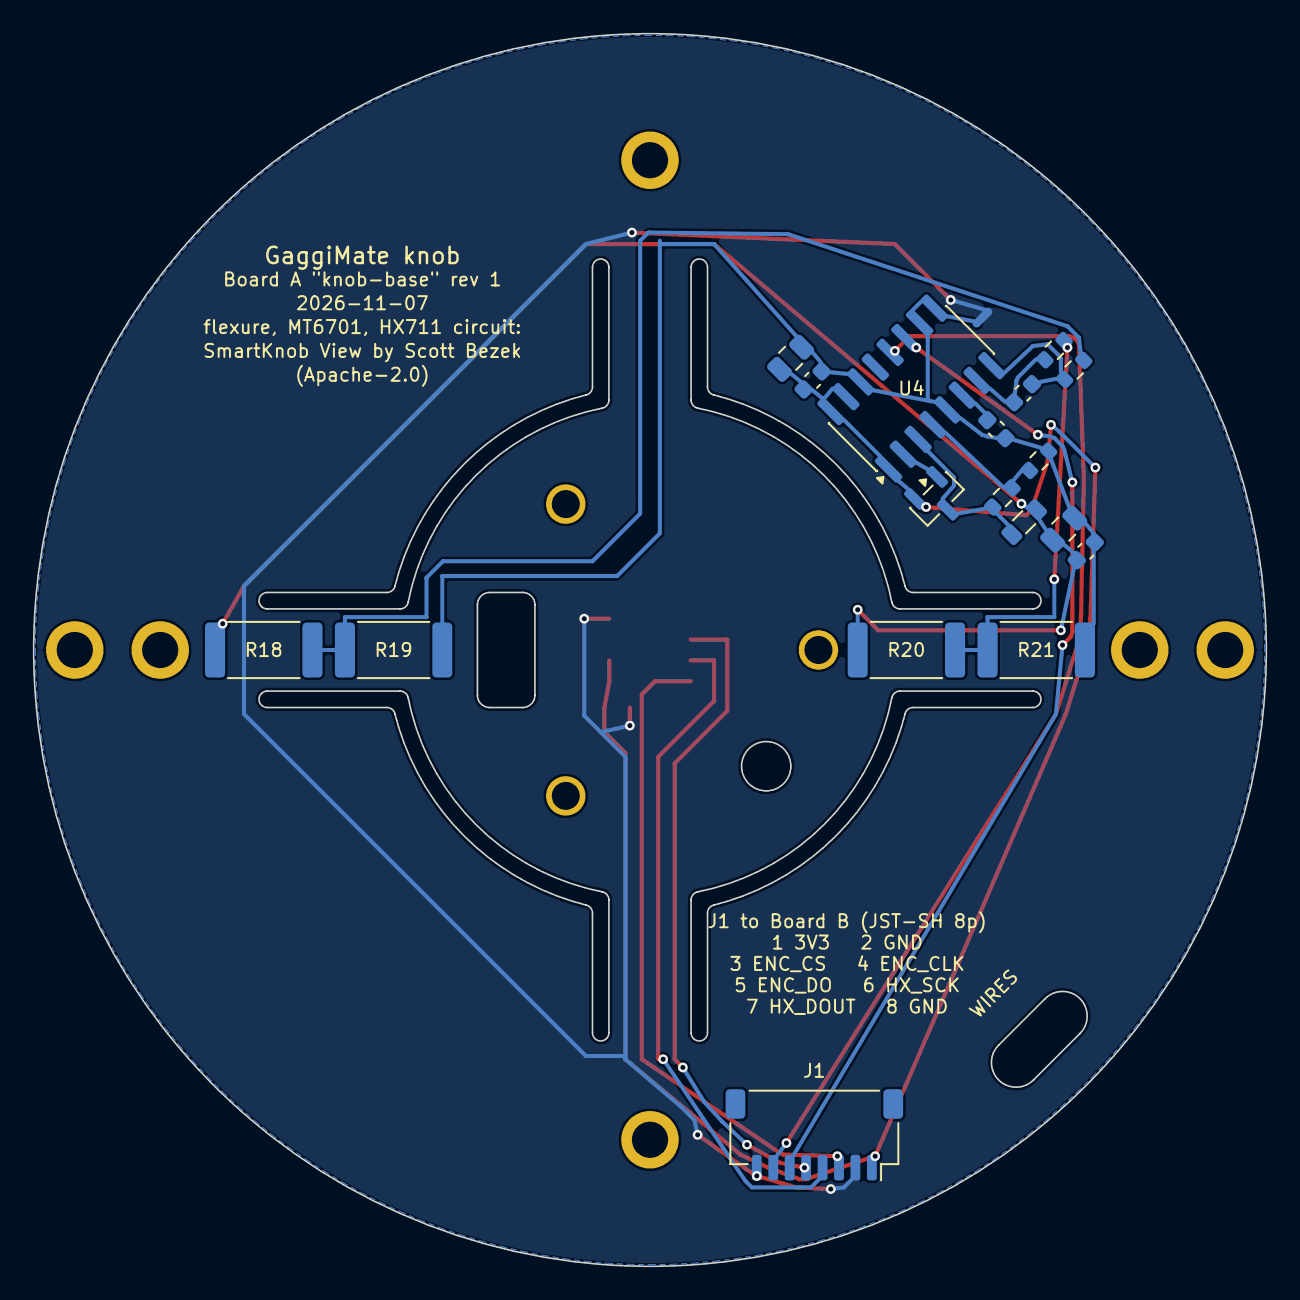
[picture p16: board knob-base.kicad_pcb from below]

Board: 2 copper layers, 75.0 x 75.0 mm, 30 parts (19 on the bottom side), 17 nets.

Other parts of the board:
H1, H2, H3: M1.6 motor; MountingHole_M1.6
H4, H5, H6, H7: M2 mount; MountingHole_2.2mm_M2_ISO7380_Pad_NonVirtual
H8, H9: D2.2 align; MountingHole_2.2mm_M2_ISO7380_Pad_NonVirtual
