SonOfPear93/gaggimate/src/display/drivers/AmoledDisplayDriver.cpp

#include "AmoledDisplayDriver.h"
#include "AmoledDisplay/pin_config.h"
#include <Wire.h>
#include <display/drivers/common/LV_Helper.h>

AmoledDisplayDriver *AmoledDisplayDriver::instance = nullptr;

static bool detectI2CDevice(uint8_t address, const char *deviceName = nullptr) {
    for (uint8_t retry = 0; retry < 5; retry++) {
        Wire.beginTransmission(address);
        if (Wire.endTransmission() == 0) {
            if (deviceName) {
                ESP_LOGI("AmoledDisplayDriver", "Found %s at 0x%02X\n", deviceName, address);
            } else {
                ESP_LOGI("AmoledDisplayDriver", "Found device at 0x%02X\n", address);
            }
            return true;
        }
        delay(100);
    }
    return false;
}

// Variant indices are persisted in NVS (GM-140) — only append, never reorder
static constexpr AmoledHwConfig VARIANTS[] = {LILYGO_T_DISPLAY_S3_DS_HW_CONFIG, WAVESHARE_S3_TOUCH_AMOLED_1_43_HW_CONFIG,
                                              WAVESHARE_S3_AMOLED_HW_CONFIG, GAGGIMATE_KNOB_AMOLED_175_HW_CONFIG};
static constexpr const char *VARIANT_NAMES[] = {"LilyGo T-Display", "Waveshare 1.43\" AMOLED Display",
                                                "Waveshare AMOLED Display", "GaggiMate Knob 1.75\" AMOLED"};
static constexpr int VARIANT_COUNT = sizeof(VARIANTS) / sizeof(VARIANTS[0]);
static_assert(VARIANTS[AmoledDisplayDriver::VARIANT_GAGGIMATE_KNOB].lcd_en == GAGGIMATE_KNOB_AMOLED_175_HW_CONFIG.lcd_en &&
                  VARIANTS[AmoledDisplayDriver::VARIANT_GAGGIMATE_KNOB].lcd_rst == GAGGIMATE_KNOB_AMOLED_175_HW_CONFIG.lcd_rst,
              "VARIANT_GAGGIMATE_KNOB must index the knob config");

bool AmoledDisplayDriver::isCompatible() {
    for (int i = 0; i < VARIANT_COUNT; i++) {
        // The knob board is selected explicitly by the display-knob build, never probed
        // (its I2C pins match the LilyGo T-Display's).
        if (i == VARIANT_GAGGIMATE_KNOB)
            continue;
        ESP_LOGI("AmoledDisplayDriver", "Testing %s...", VARIANT_NAMES[i]);
        if (testHw(VARIANTS[i])) {
            hwConfig = VARIANTS[i];
            variant = i;
            return true;
        }
    }
    return false;
}

bool AmoledDisplayDriver::selectVariant(int variant) {
    if (variant < 0 || variant >= VARIANT_COUNT)
        return false;
    hwConfig = VARIANTS[variant];
    this->variant = variant;
    return true;
}

void AmoledDisplayDriver::init() {
    panel = new Amoled_DisplayPanel(hwConfig);
    ESP_LOGI("AmoledDisplayDriver", "Initializing LilyGo T-Display...");

    if (!panel->begin()) {
        for (uint8_t i = 0; i < 20; i++) {
            ESP_LOGE("AmoledDisplayDriver", "Error, failed to initialize T-Display");
            delay(1000);
        }
        ESP.restart();
    }

    beginLvglHelper(*panel);
}

bool AmoledDisplayDriver::supportsSDCard() { return hwConfig.sd_cs >= 0; } // the knob board has no SD slot

bool AmoledDisplayDriver::installSDCard() { return panel->installSD(); }

bool AmoledDisplayDriver::testHw(AmoledHwConfig hwConfig) {
    // No Wire on these pins, definitely wrong board
    if (!Wire.begin(hwConfig.i2c_sda, hwConfig.i2c_scl))
        return false;

    // Required: PCF8563 (RTC) when present, and a touch sensor
    // Touch sensor: Either CST92XX (1.75 inch) or FT3168 (1.43 inch)
    // Some boards (e.g. Waveshare 1.43") have no PCF8563 RTC; skip that check for them
    bool pcf8563Found = (hwConfig.pcf8563_int == -1) || detectI2CDevice(PCF8563_DEVICE_ADDRESS, "PCF8563 RTC");

    bool touchFound = detectI2CDevice(CST92XX_DEVICE_ADDRESS, "CST92XX Touch Sensor") ||
                      detectI2CDevice(FT3168_DEVICE_ADDRESS, "FT3168 Touch Sensor");

    Wire.end();
    return pcf8563Found && touchFound;
}
