SonOfPear93/gaggimate/src/display/drivers/AmoledDisplay/pin_config.h

#pragma once

struct AmoledHwConfig {
    int8_t lcd_sdio0;
    int8_t lcd_sdio1;
    int8_t lcd_sdio2;
    int8_t lcd_sdio3;
    int8_t lcd_sclk;
    int8_t lcd_cs;
    int8_t lcd_rst;
    uint16_t lcd_width;
    uint16_t lcd_height;
    int8_t lcd_gram_offset_x;
    int8_t lcd_gram_offset_y;
    int8_t lcd_en;
    int8_t i2c_sda;
    int8_t i2c_scl;
    int8_t tp_int;
    int8_t tp_rst;
    int8_t battery_voltage_adc_data;
    int8_t sd_cs;
    int8_t sd_mosi;
    int8_t sd_miso;
    int8_t sd_sclk;
    int8_t pcf8563_int;
    int8_t rotation_175;
    bool mirror_touch;
};

constexpr AmoledHwConfig LILYGO_T_DISPLAY_S3_DS_HW_CONFIG{
    .lcd_sdio0 = 11,
    .lcd_sdio1 = 13,
    .lcd_sdio2 = 14,
    .lcd_sdio3 = 15,
    .lcd_sclk = 12,
    .lcd_cs = 10,
    .lcd_rst = 17,
    .lcd_width = 466,
    .lcd_height = 466,
    .lcd_gram_offset_x = 6,
    .lcd_gram_offset_y = 8,
    .lcd_en = 16,
    .i2c_sda = 7,
    .i2c_scl = 6,
    .tp_int = 9,
    .tp_rst = -1,
    .battery_voltage_adc_data = 4,
    .sd_cs = 38,
    .sd_mosi = 39,
    .sd_miso = 40,
    .sd_sclk = 41,
    .pcf8563_int = 9,
    .rotation_175 = 2,
    .mirror_touch = false,
};

constexpr AmoledHwConfig WAVESHARE_S3_AMOLED_HW_CONFIG{
    .lcd_sdio0 = 4,
    .lcd_sdio1 = 5,
    .lcd_sdio2 = 6,
    .lcd_sdio3 = 7,
    .lcd_sclk = 38,
    .lcd_cs = 12,
    .lcd_rst = 39,
    .lcd_width = 466,
    .lcd_height = 466,
    .lcd_gram_offset_x = 6,
    .lcd_gram_offset_y = 0,
    .lcd_en = 13,
    .i2c_sda = 15,
    .i2c_scl = 14,
    .tp_int = 11,
    .tp_rst = -1,
    .battery_voltage_adc_data = -1,
    .sd_cs = 41,
    .sd_mosi = 1,
    .sd_miso = 3,
    .sd_sclk = 2,
    .pcf8563_int = -1,
    .rotation_175 = 0,
    .mirror_touch = true,
};

constexpr AmoledHwConfig WAVESHARE_S3_TOUCH_AMOLED_1_43_HW_CONFIG{
    .lcd_sdio0 = 11,
    .lcd_sdio1 = 12,
    .lcd_sdio2 = 13,
    .lcd_sdio3 = 14,
    .lcd_sclk = 10,
    .lcd_cs = 9,
    .lcd_rst = 21,
    .lcd_width = 466,
    .lcd_height = 466,
    .lcd_gram_offset_x = 6,
    .lcd_gram_offset_y = 6,
    .lcd_en = -1,
    .i2c_sda = 47,
    .i2c_scl = 48,
    .tp_int = -1,
    .tp_rst = -1,
    .battery_voltage_adc_data = -1,
    .sd_cs = 38,
    .sd_mosi = 39,
    .sd_miso = 40,
    .sd_sclk = 41,
    .pcf8563_int = -1,
    .rotation_175 = 0,
    .mirror_touch = false,
};

// GaggiMate Knob main board (ESP32-S3-WROOM-1-N16R8) with the Waveshare 1.75" CO5300 +
// CST9217 panel; GPIOs from the knob design doc §5 (mirrored in display/knob/KnobPins.h).
// Panel offsets / touch mirroring copied from WAVESHARE_S3_AMOLED_HW_CONFIG (same panel).
// No RTC, no SD card, no battery ADC. Touch is optional on this board.
constexpr AmoledHwConfig GAGGIMATE_KNOB_AMOLED_175_HW_CONFIG{
    .lcd_sdio0 = 11,
    .lcd_sdio1 = 13,
    .lcd_sdio2 = 14,
    .lcd_sdio3 = 15,
    .lcd_sclk = 12,
    .lcd_cs = 10,
    .lcd_rst = 16,
    .lcd_width = 466,
    .lcd_height = 466,
    .lcd_gram_offset_x = 6,
    .lcd_gram_offset_y = 0,
    .lcd_en = 17,
    .i2c_sda = 7,
    .i2c_scl = 6,
    .tp_int = 9,
    .tp_rst = 8,
    .battery_voltage_adc_data = -1,
    .sd_cs = -1,
    .sd_mosi = -1,
    .sd_miso = -1,
    .sd_sclk = -1,
    .pcf8563_int = -1,
    .rotation_175 = 0,
    .mirror_touch = true,
};

#define CST92XX_DEVICE_ADDRESS 0x5A
#define FT3168_DEVICE_ADDRESS 0x38
#define PCF8563_DEVICE_ADDRESS 0x51
#define SY6970_DEVICE_ADDRESS 0x6A
