SonOfPear93/gaggimate/(commit log)

2026-11-07 feat(knob): haptic knob input for the display firmware
    Adds a `display-knob` build for an ESP32-S3-WROOM-1-N16R8 board driving a
    1.75" CO5300 AMOLED with a SmartKnob-style BLDC haptic knob:
    - MotorTask (SimpleFOC 2.3.3, DRV8311H 3x PWM, MT6701 over SSI) and
    DetentModel ported from SmartKnob (Apache-2.0, headers kept)
    - HX711 strain-gauge press detection with running tare, short/long press,
    and guided calibration from the BOOT button
    - KnobNavigator: navigate/edit modes, per-screen focus lists, haptic config
    per focus, reusing the existing action_* handlers
    - Focus ring overlay on the LVGL top layer
    - Knob emulation in display-sim (--knob, --knob-script, --knob-shots)
    - Unity tests for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
    [AmoledDisplayDriver.cpp, AmoledDisplayDriver.h, Amoled_DisplayPanel.cpp, Controller.cpp, DefaultUI.cpp, DefaultUI.h, DetentModel.cpp, DetentModel.h]
2026-11-07 hw(knob): board A knob-base flexure PCB rev 1
    Round 75 mm, 1.2 mm board derived from SmartKnob View view_base
    (Scott Bezek, Apache-2.0): flexure, strain gauges, MT6701, HX711,
    JST-SH 8-pin to the main board. Scripted generation, ERC/DRC clean,
    JLC fab outputs. Design doc: move board B holes off the wire slot.
    [knob-base-BOM-JLC.csv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]
2026-11-07 hw(knob): 3D-printed enclosure rev 1 (build123d)
    Knob ring, screen platform, modified SmartKnob MountBase, front case and
    Gaggia Classic / Classic Pro back cases with the GaggiMate housing-edge
    groove plus a thumbscrew clamp. STEP/STL/print-oriented STLs, renders and
    an interference check (clean). Case widened to 78.6 mm for a 1.55 mm wall.
    Reuses SmartKnob RotorSpacer (CC-BY-4.0).
    [RotorSpacer.stl]
2026-11-07 hw(knob): align enclosure USB-C opening with final knob-main J1
2026-11-07 hw(knob): board B knob-main and board C knob-screen PCBs rev 1
    knob-main: Ø74 mm 4-layer, ESP32-S3-WROOM-1-N16R8, DRV8311H (3x PWM),
    USB-C + GaggiMate JST-XH power (diode-ORed), AP7361C 3V3 LDO, switched
    panel supply, JST-SH link to knob-base, wire/motor pads under the slot.
    knob-screen: Ø46 mm adapter with FH26W 31-pin FPC for the 1.75" CO5300
    panel (Waveshare pinout) and 13 wire pads. Scripted generation,
    ERC/DRC clean, JLC fab outputs.
    [knob-main-BOM.csv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]
